sjpilot/ESP32BrewHA/PCB/BOM_ESP32 BrewPILess_PCB_2024-01-04.csv

No. | Quantity | Comment | Designator | Footprint | Value | Manufacturer Part | Manufacturer | Supplier Part | Supplier | JLCPCB Stock | JLCPCB Price | LCSC Stock | LCSC Price
1 | 2 | 100nF | C1,C2 | CAP-TH_L12.0-W5.5-P10.00-D0.6 | 100nF | MPP104J2W10AJ22620 | KNSCHA(科尼盛) | C506846 | LCSC | 5981 | 0.227 | 11860 | 0.0362
2 | 1 | 1uF | C3 | C0805 | 1uF | CL21B105KBFNNNE | SAMSUNG(三星) | C28323 | LCSC | 4024774 | 0.0554
3 | 3 | 10uF | C4,C23,C24 | C0805 | 10uF | GRM21BR61H106KE43L | muRata(村田) | C440198 | LCSC | 1307636 | 0.449 | 1040422 | 0.0714
4 | 2 | 22uF | C5,C14 | C0805 | 22uF | CL21A226MAQNNNE | SAMSUNG(三星) | C45783 | LCSC | 6337334 | 0.165
5 | 7 | 100nF | C13,C16,C22,C41,C42,C43,C61 | C0805 | 100nF | CC0805KRX7R9BB104 | YAGEO(国巨) | C49678 | LCSC | 5288508 | 0.0284
6 | 3 | SM4007PL | D1,D2,D3 | SOD-123F_L2.8-W1.8-LS3.7-RD |  | SM4007PL | MDD | C64898 | LCSC | 609110 | 0.0427
7 | 1 | 5x20环保保险管夹/座 | F21 | FUSE-TH_5X20RHOSFUSECLIP-SEAT |  | 5x20环保保险管夹/座 | xcfuse(旭程) | C3130 | LCSC | 105328 | 0.118
8 | 1 | 5A | F22 | FUSE-TH_5X20RHOSFUSECLIP-SEAT |  | 5x20环保保险管夹/座 | xcfuse(旭程) | C3130 | LCSC | 105328 | 0.118
9 | 1 | 1A | F210 | FUSE-TH_5X20RHOSFUSECLIP-SEAT |  | 5x20环保保险管夹/座 | xcfuse(旭程) | C3130 | LCSC | 105328 | 0.118
10 | 1 | 10A | F220 | FUSE-TH_5X20RHOSFUSECLIP-SEAT |  | 5x20环保保险管夹/座 | xcfuse(旭程) | C3130 | LCSC | 105328 | 0.118
11 | 1 | PROG | J5 | IDC-TH_6P-P2.54_C11214 |  | 2.54-2*3P简牛 | BOOMELE(博穆精密) | C11214 | LCSC | 427 | 0.569 | 1820 | 0.0906
12 | 6 | WJ500V-5.08-2P | J41,P28,P29,P31,P32,P33 | CONN-TH_2P-P5.00_WJ500V-5.08-2P |  | WJ500V-5.08-2P | KANGNEX(康奈克斯电气) | C8465 | LCSC | 4281 | 0.591
13 | 3 | 973-5VDC-SL-A15A250VAC | K1,K2,K3 | RELAY-TH_973-XXVDC-SL-A |  | 973-5VDC-SL-A15A250VAC | NHC(汇龙仓) | C396951 | LCSC | 500 | 2.53 | 500 | 0.4026
14 | 1 | UU10.5Y-10mH | L1 | FILTER-TH_UU10.5Y-10MH |  | UU10.5Y-10mH | FH(风华) | C75196 | LCSC | 99 | 2.45
15 | 4 | WJ500V-5.08-3P | P1,P21,P22,P23 | CONN-TH_3P-P5.00_WJ500V-5.08-3P |  | WJ500V-5.08-3P | KANGNEX(康奈克斯电气) | C72334 | LCSC | 2495 | 1.0057
16 | 2 | 12kΩ | R1,R13 | R0805 | 12kΩ | 0805W8F1202T5E | UNI-ROYAL(厚声) | C17444 | LCSC | 231438 | 0.0111
17 | 1 | 10D561K | R9 | RES-TH_L13.0-W6.0-P7.50-D0.9-S6.00 |  | 10D561K | HEL(鸿志) | C113236 | LCSC | 1992 | 0.326 | 7940 | 0.0520
18 | 1 | 4.7kΩ | R12 | R0805 | 4.7kΩ | 0805W8F4701T5E | UNI-ROYAL(厚声) | C17673 | LCSC | 2540518 | 0.0107
19 | 2 | 200Ω | R41,R42 | R0805 | 200Ω | 0805W8F2000T5E | UNI-ROYAL(厚声) | C17540 | LCSC | 381654 | 0.0107
20 | 2 | 56kΩ | R43,R44 | R0805 | 56kΩ | ARG05DTC5602 | Viking(光颉) | C2828780 | LCSC | 3338 | 0.0562 | 2900 | 0.0090
21 | 2 | 2.4kΩ | R61,R62 | R0805 | 2.4kΩ | 0805W8F2401T5E | UNI-ROYAL(厚声) | C17526 | LCSC | 177349 | 0.0106
22 | 2 | TS-1187A-B-A-B | SW1,SW2 | SW-SMD_4P-L5.1-W5.1-P3.70-LS6.5-TL-2 |  | TS-1187A-B-A-B | XKB Connectivity(中国星坤) | C318884 | LCSC | 284242 | 0.097 | 453300 | 0.0155
23 | 1 | HLK-5M05 | U1 | PWRM-TH_HLK-5M05 |  | HLK-5M05 | HI-LINK(海凌科) | C209907 | LCSC | 1039 | 15.75 | 1135 | 2.5057
24 | 1 | 2.4GHz | U11 | WIRELM-SMD_ESP32-S3-WROOM-1 | 2.4GHz | ESP32-S3-WROOM-1-N8R2 | ESPRESSIF(乐鑫) | C2913204 | LCSC | 1860 | 27.51 | 2075 | 4.3766
25 | 1 | LM1117RS-3.3 | U23 | TO-252-2_L6.6-W6.1-P4.57-LS9.9-TL-CW |  | LM1117RS-3.3 | HTC | C126023 | LCSC | 270 | 1.671 | 293 | 0.2658
26 | 1 | ULN2003ADR | U32 | SOIC-16_L9.9-W3.9-P1.27-LS6.0-BL |  | ULN2003ADR | TI(德州仪器) | C7512 | LCSC | 481390 | 0.911
27 | 1 | MAX31865ATP+T | U41 | QFN-20_L5.0-W5.0-P0.65-BL-EP |  | MAX31865ATP+T | ADI(亚德诺) | C118474 | LCSC | 3536 | 17.09 | 5878 | 2.7189
28 | 1 | ATECC608A-SSHDA-T | U61 | SOIC-8_L4.9-W3.9-P1.27-LS6.0-BL |  | ATECC608A-SSHDA-T | MICROCHIP(美国微芯) | C616024 | LCSC | 905 | 8.4 | 885 | 1.3364
29 | 1 | TYPE-C 14P LTH10.0 | USB1 | TYPE-C-SMD_918-468K2029Y50001 |  | TYPE-C 14P LTH10.0 | SHOU HAN(首韩) | C5187467 | LCSC | 3423 | 1.831 | 7235 | 0.2914
