sjpilot/ESP32BrewHA/Schematic/SCH_esp32 brewpiless_2024-01-04.pdf

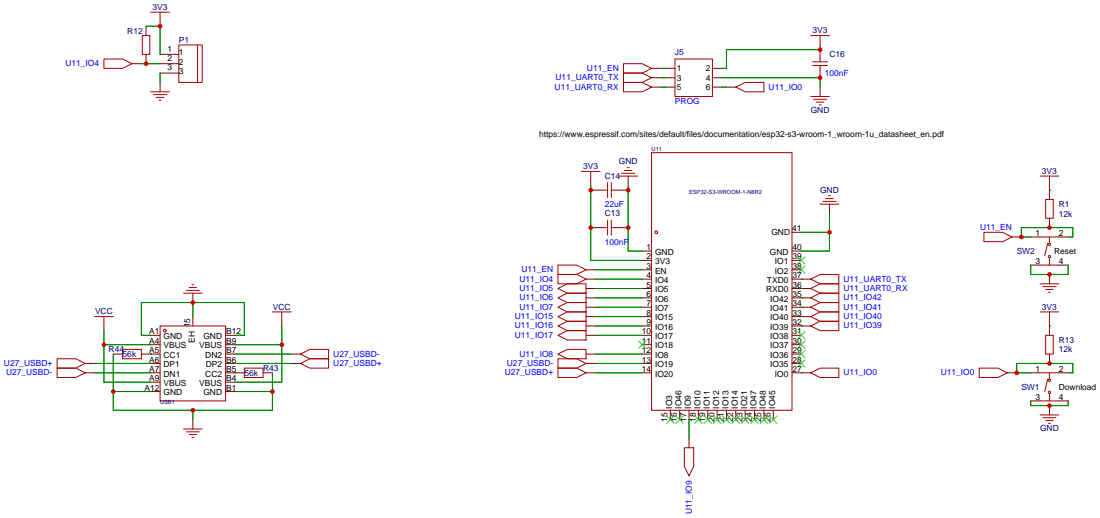
[picture p4: page 1]

https://www.espressif.com/sites/default/files/documentation/esp32-s3-wroom-1_wroom-1u_datasheet_en.pdf

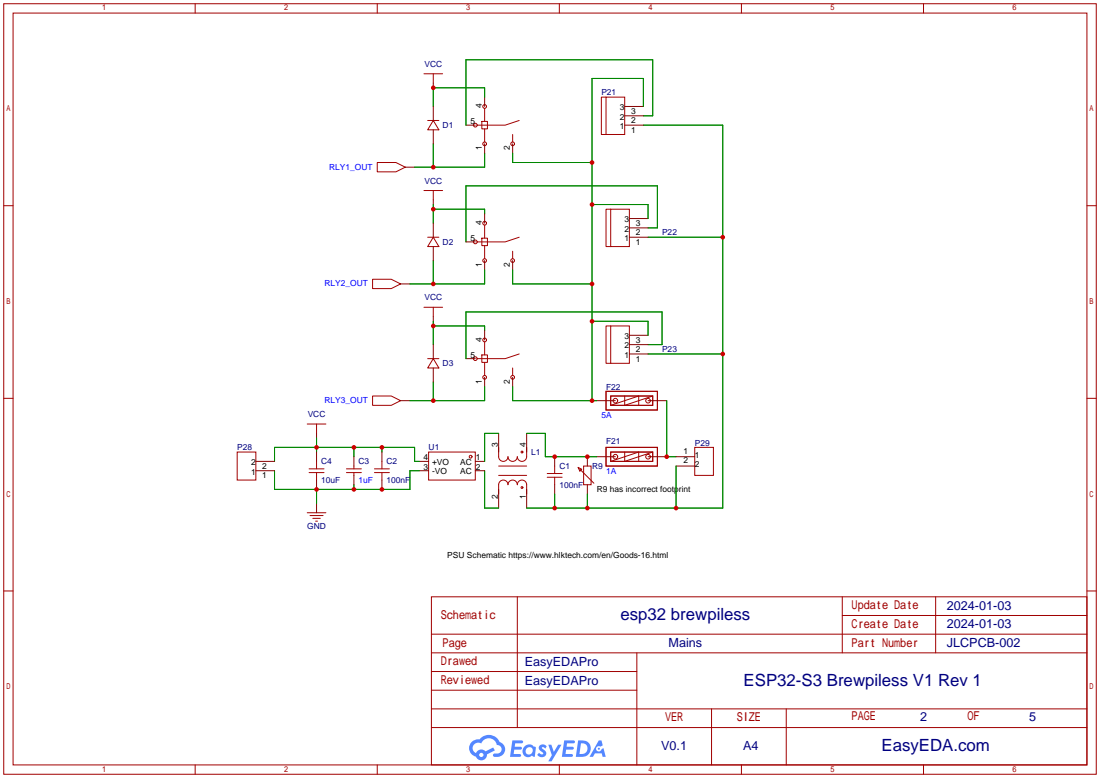
[picture p5: page 2]

PSU Schematic https://www.hlktech.com/en/Goods-16.html

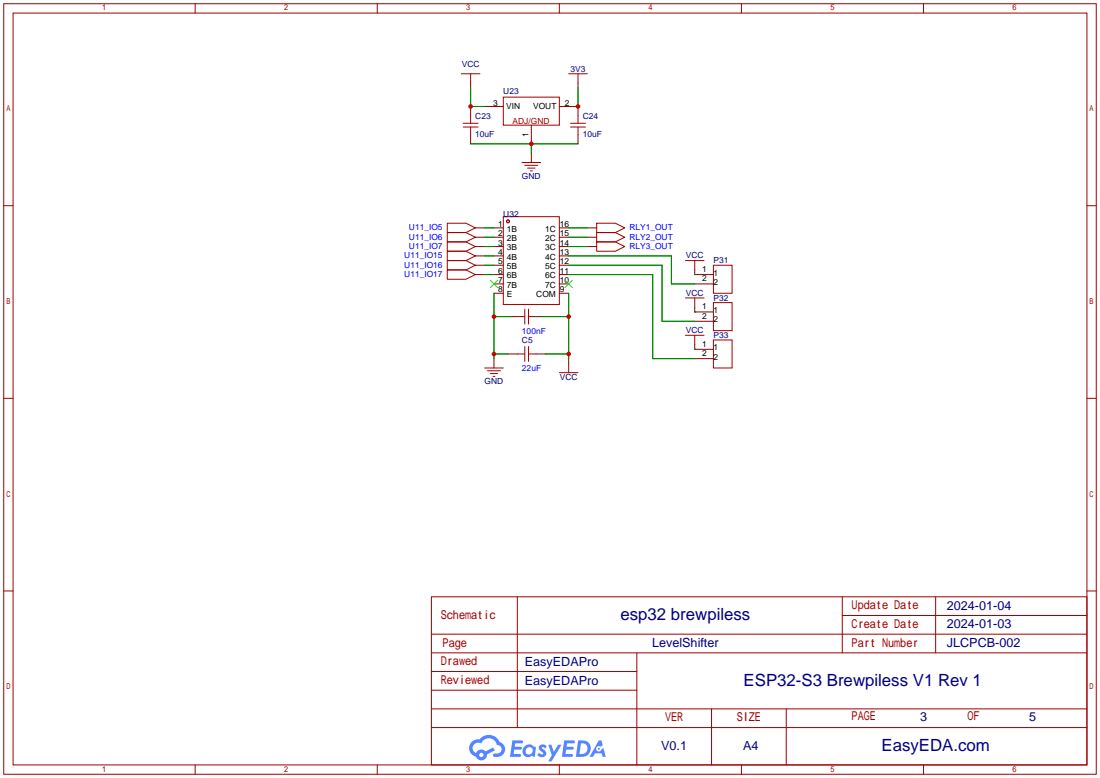
[picture p6: page 3]

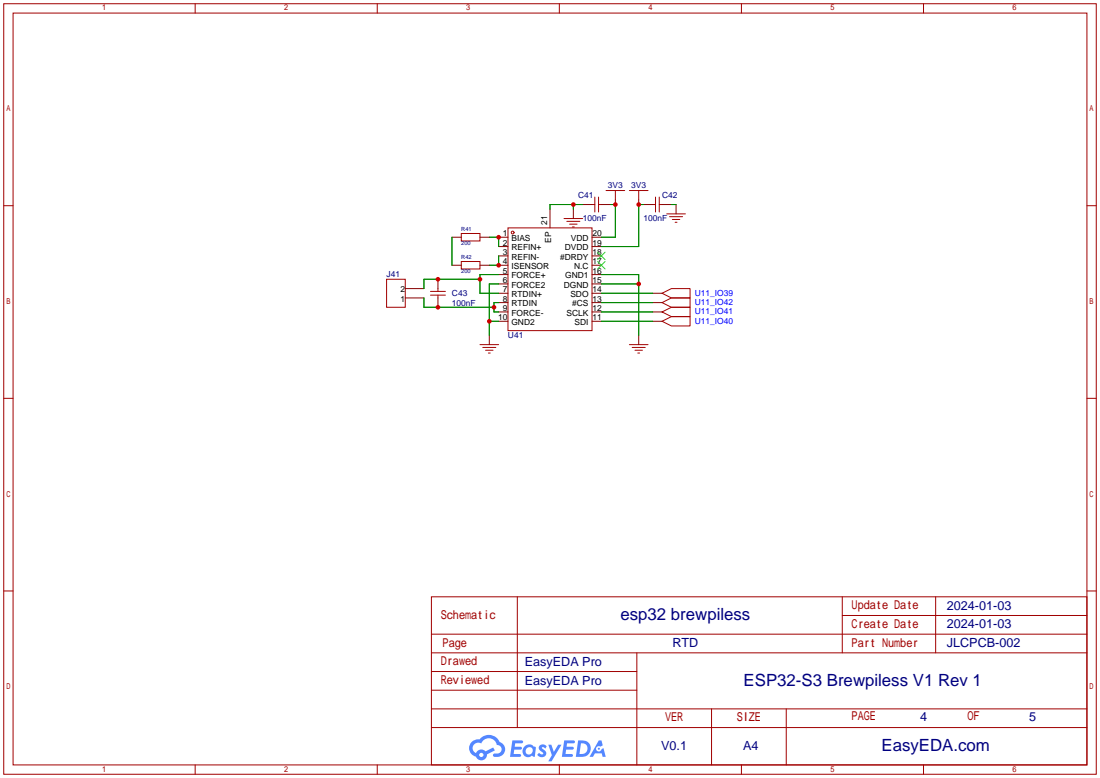
[picture p7: page 4]

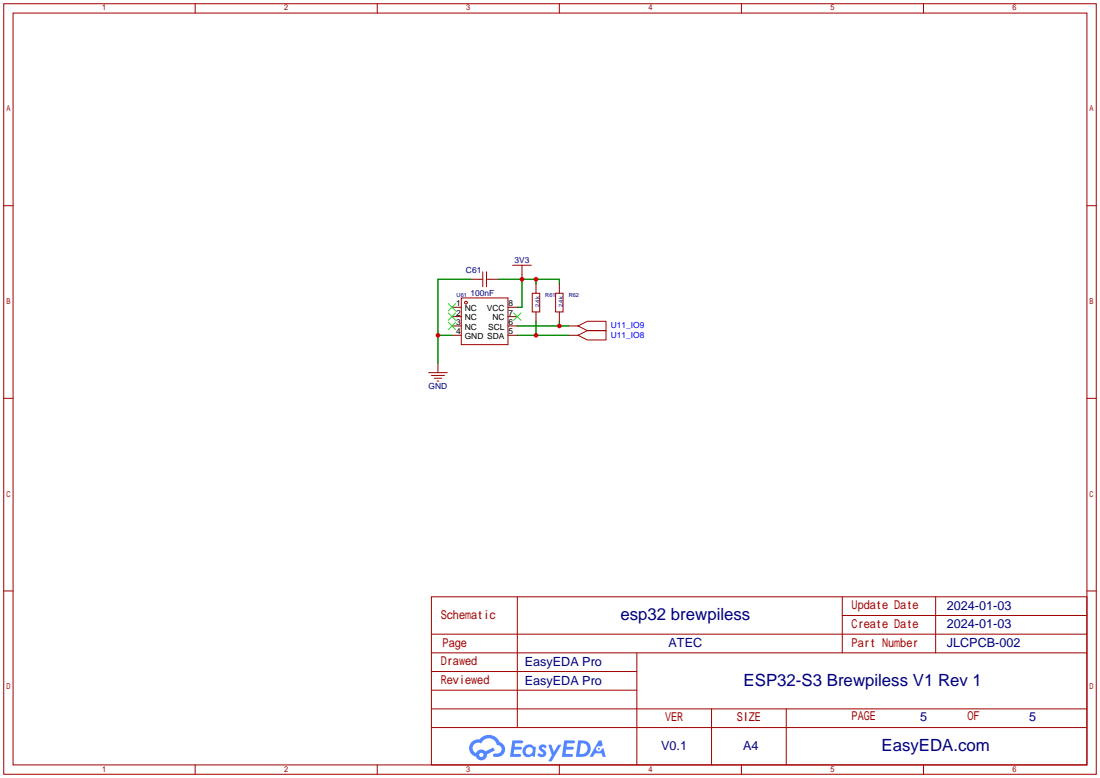
[picture p8: page 5]
