sjpilot/ESP32BrewHA/(list of files, drawings)

Other design files:
EasyEDA Pro Project/ProDocument_esp32 brewpiless_2024-01-04.epro
EasyEDA Pro Project/ProDocument_PCB_2024-01-04.epro
EasyEDA Pro Project/ProProject_ESP32-S3 Brewpiless V1 Rev 1_2024-01-04.epro
