sjpilot/ESP32BrewHA/(threads)

Thread 1 (2024-01-15):

USB-C cable not working

sjpilot, 2024-01-15:
The following schematic shows a 22ohm resistor + capacitors on the USB_D+ - lines. This may need to be added.
https://files.seeedstudio.com/wiki/SeeedStudio-XIAO-ESP32S3/res/XIAO_ESP32S3_SCH_v1.1.pdf

As an alternative, a USB A to USB C cable may work as that doesn't require CC lines etc to function.

Programming via header works with ESP PROG
