sjpilot/ESP32BrewHA/(commit log)

2024-01-04 Ordered with JLCPCB, batch #1
    [BOM_ESP32 BrewPILess_PCB_2024-01-04.csv, PickAndPlace_PCB_2024-01-04.csv, ProDocument_PCB_2024-01-04.epro, ProDocument_esp32 brewpiless_2024-01-04.epro, ProProject_ESP32-S3 Brewpiless V1 Rev 1_2024-01-04.epro]
2024-02-18 Running on ESP32-S3-WROOM-1-N8R2, logging to UART0 ESP-PROG Header,
